rmheuer/eeprom-programmer/README.md

# eeprom-programmer

Programmer for AT28C64 and 24LC32 EEPROMs.

[Schematic](hardware/schematic.pdf)

##### Assembled PCB:
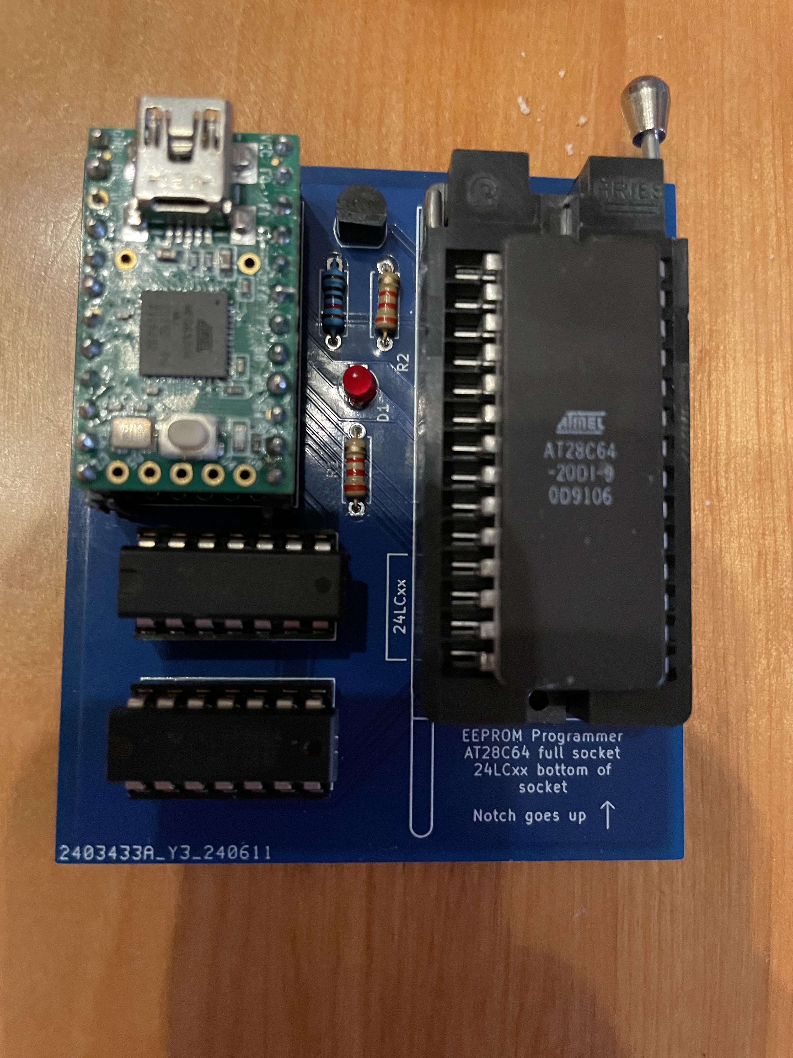
[picture p1: images/real.jpg]


##### PCB in KiCad:
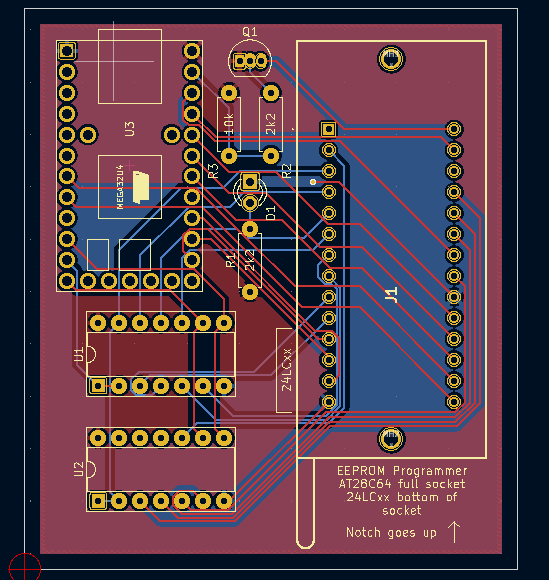
[picture p2: images/pcb.png]
