rmheuer/eeprom-programmer/hardware/schematic.pdf

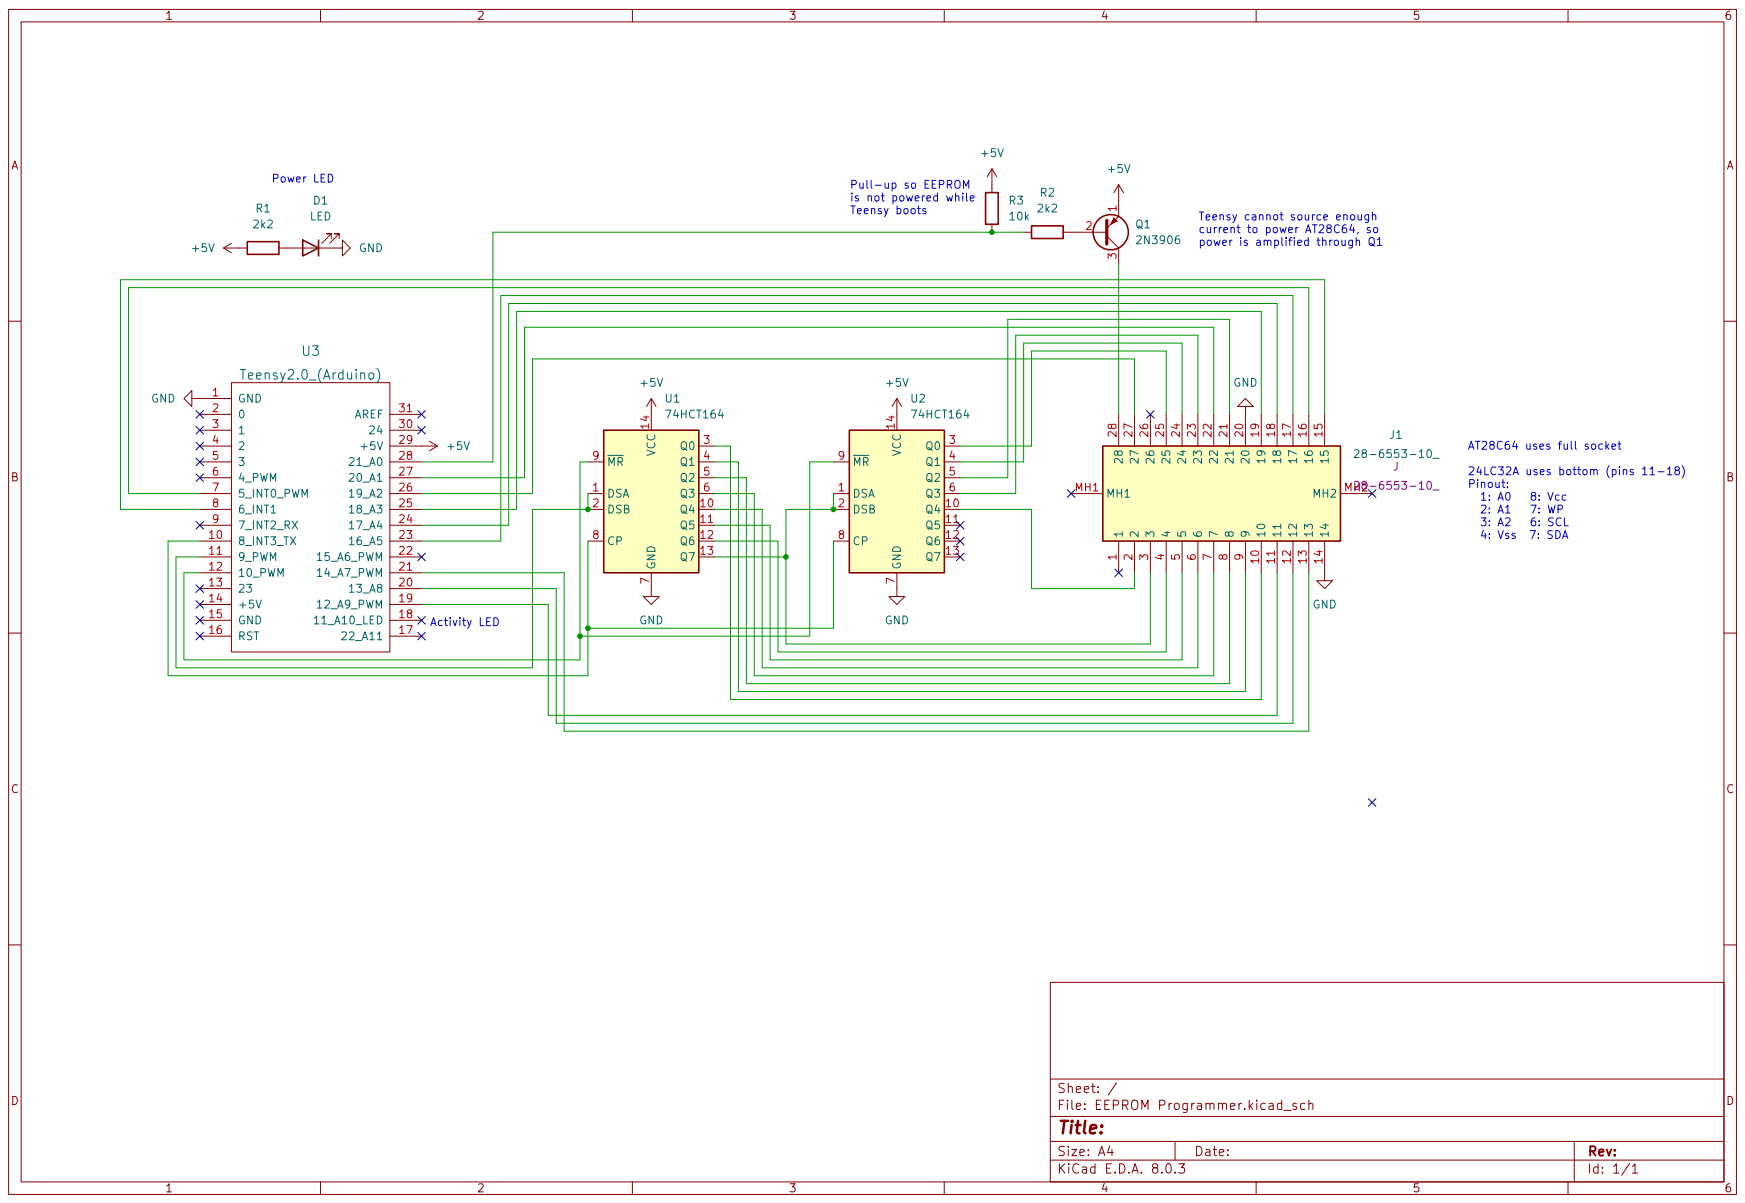
[picture p3: page 1]
