rmheuer/eeprom-programmer/(commit log)

2024-05-25 Add hardware
    [EEPROM Programmer.kicad_pcb, EEPROM Programmer.kicad_sch]
2024-05-25 add power LED
    [EEPROM Programmer.kicad_pcb, EEPROM Programmer.kicad_sch]
2024-05-25 rearrange traces
    [EEPROM Programmer.kicad_pcb]
2024-05-28 add Microchip 24LCxx support
    [EEPROM Programmer.kicad_pcb, EEPROM Programmer.kicad_sch]
2024-06-09 Update PCB to KiCad 8
    [EEPROM Programmer.kicad_pcb, EEPROM Programmer.kicad_sch]
